AshishRamesh/Project-ARIA/(commit log)

2024-07-04 pcb img added
2024-07-08 ROS Arduino Bridge for pi to arduino communication
2024-07-08 Simulation Files
    [ball_tracker_params_robot.yaml, camera.xacro, depth_camera.xacro, face.xacro, gazebo_control.xacro, inertial_macros.xacro, lidar.xacro, my_controllers.yaml]
2024-07-08 Diff Drive controller
    [ball_tracker_params_robot.yaml, camera.xacro, depth_camera.xacro, face.xacro, gazebo_control.xacro, inertial_macros.xacro, lidar.xacro, my_controllers.yaml]
2024-07-16 lidar vid
